aghidalgo04/SistemaDeteccionGasesHogar/SistemaDeteccionGasesHogar.srcs/sources_1/new/top_module.vhd

library IEEE;
use IEEE.STD_LOGIC_1164.ALL;

entity top_module is
    Port ( 
        CLK         : in STD_LOGIC;
        sw          : in STD_LOGIC;
        JA          : in STD_LOGIC_VECTOR(1 DOWNTO 0);
        S_CLOCK1HZ  : out STD_LOGIC;
        VENT        : out STD_LOGIC;
        LED_ZUM     : out STD_LOGIC;
        ESP_S       : out STD_LOGIC_VECTOR(1 downto 0);
        led         : out STD_LOGIC_VECTOR(15 DOWNTO 0);
        an          : out STD_LOGIC_VECTOR(3 DOWNTO 0);
        seg         : out STD_LOGIC_VECTOR(6 DOWNTO 0);
        dp          : out STD_LOGIC
    );
end top_module;

architecture Behavioral of top_module is
    component DivisorFrecuencia
        GENERIC(N: integer := 22);
        Port ( 
            CLK_10MHz : in STD_LOGIC;
            CLK_1Hz : out STD_LOGIC
        );
    end component;
    
    component display is
        Port ( 
            clk    : in  STD_LOGIC;
            bin_in : in  STD_LOGIC_VECTOR(11 DOWNTO 0);
            an     : out STD_LOGIC_VECTOR(3 DOWNTO 0);
            seg    : out STD_LOGIC_VECTOR(6 DOWNTO 0);
            dp     : out STD_LOGIC
        );
    end component;
    
    component DEMUX_1a2
        Port (
           entrada : in STD_LOGIC_VECTOR (11 downto 0);
           salida_M : out STD_LOGIC_VECTOR (11 downto 0);
           salida_C : out STD_LOGIC_VECTOR (11 downto 0);
           S : in STD_LOGIC
        );
    end component;
    
    component Registro12Bits
        GENERIC(N: integer := 12);
        Port ( 
            CLK : in STD_LOGIC;
            entrada : in STD_LOGIC_VECTOR (N-1 downto 0);
            salida : out STD_LOGIC_VECTOR (N-1 downto 0)
        );
    end component;
    
    component xadc
        Port ( 
           clk : in STD_LOGIC;
           sw : in STD_LOGIC;
           JA : in STD_LOGIC_VECTOR(1 DOWNTO 0);
           led : out STD_LOGIC_VECTOR(15 DOWNTO 0)
         );
    end component;
     
    component Comparador
        port ( 
           CO2 : in STD_LOGIC_VECTOR(11 downto 0);
           Metano : in STD_LOGIC_VECTOR(11 downto 0);
           s_vent : out STD_LOGIC;
           s_led_zum : out STD_LOGIC;
           ESP : out STD_LOGIC_VECTOR(1 downto 0)
         );
    end component;
    
    signal sCLK_1Hz, sCLK_1Hz_inv : STD_LOGIC;
    signal led_aux : STD_LOGIC_VECTOR(15 DOWNTO 0);
    signal xadc_value, salida_metano, salida_co2, salida_reg_met, salida_reg_co2: STD_LOGIC_VECTOR(11 DOWNTO 0);
    signal sS_vent, sS_led_zum : STD_LOGIC;
    signal sESP : STD_LOGIC_VECTOR(1 downto 0);
begin
    inst_divisorFrecuencia: DivisorFrecuencia
    PORT MAP(
        CLK_10MHz => CLK,
        CLK_1Hz => sCLK_1Hz
    );
    
    inst_xadc: xadc
    PORT MAP(
        clk => sCLK_1Hz,
        sw => sw,
        JA => JA,
        led => led_aux
    );
    
    xadc_value <= led_aux(15 DOWNTO 4);
    led <= led_aux;
    
    inst_demux: DEMUX_1a2
    PORT MAP(
        entrada => xadc_value,
        salida_M => salida_metano,
        salida_C => salida_co2,
        S => sCLK_1Hz
    );
    
    sCLK_1Hz_inv <= not(sCLK_1Hz);
    
    inst_registroM : Registro12Bits
    PORT MAP(
        CLK => sCLK_1Hz_inv,
        entrada => salida_metano,
        salida => salida_reg_met
    );
    
    inst_registroC : Registro12Bits
    PORT MAP(
        CLK => sCLK_1Hz,
        entrada => salida_co2,
        salida => salida_reg_co2
    );

--   ==== alternativa metano ====

--    inst_display_met : display
--    PORT MAP(
--            clk    => CLK,
--            bin_in => salida_reg_met,
--            an     => an,
--            seg    => seg,
--            dp     => dp
--    );
    
    inst_display_co2 : display
    PORT MAP(
            clk    => CLK,
            bin_in => salida_reg_co2,
            an     => an,
            seg    => seg,
            dp     => dp
    );
    
    inst_comparador : Comparador
    PORT MAP ( 
           CO2 => salida_reg_co2,
           Metano => salida_reg_met,
           s_vent => sS_vent,
           s_led_zum => sS_led_zum,
           ESP => sESP
         );

end Behavioral;
