aghidalgo04/SistemaDeteccionGasesHogar/SistemaDeteccionGasesHogar.srcs/constrs_1/new/Basys3_Master.xdc

## Clock signal
set_property PACKAGE_PIN W5 [get_ports CLK]
set_property IOSTANDARD LVCMOS33 [get_ports CLK]
create_clock -period 10.000 -name sys_clk_pin -waveform {0.000 5.000} -add [get_ports CLK]

## Switches
set_property PACKAGE_PIN V17 [get_ports sw]
set_property IOSTANDARD LVCMOS33 [get_ports sw]


## LEDs
set_property PACKAGE_PIN U16 [get_ports {led[0]}]
set_property IOSTANDARD LVCMOS33 [get_ports {led[0]}]
set_property PACKAGE_PIN E19 [get_ports {led[1]}]
set_property IOSTANDARD LVCMOS33 [get_ports {led[1]}]
set_property PACKAGE_PIN U19 [get_ports {led[2]}]
set_property IOSTANDARD LVCMOS33 [get_ports {led[2]}]
set_property PACKAGE_PIN V19 [get_ports {led[3]}]
set_property IOSTANDARD LVCMOS33 [get_ports {led[3]}]
set_property PACKAGE_PIN W18 [get_ports {led[4]}]
set_property IOSTANDARD LVCMOS33 [get_ports {led[4]}]
set_property PACKAGE_PIN U15 [get_ports {led[5]}]
set_property IOSTANDARD LVCMOS33 [get_ports {led[5]}]
set_property PACKAGE_PIN U14 [get_ports {led[6]}]
set_property IOSTANDARD LVCMOS33 [get_ports {led[6]}]
set_property PACKAGE_PIN V14 [get_ports {led[7]}]
set_property IOSTANDARD LVCMOS33 [get_ports {led[7]}]
set_property PACKAGE_PIN V13 [get_ports {led[8]}]
set_property IOSTANDARD LVCMOS33 [get_ports {led[8]}]
set_property PACKAGE_PIN V3 [get_ports {led[9]}]
set_property IOSTANDARD LVCMOS33 [get_ports {led[9]}]
set_property PACKAGE_PIN W3 [get_ports {led[10]}]
set_property IOSTANDARD LVCMOS33 [get_ports {led[10]}]
set_property PACKAGE_PIN U3 [get_ports {led[11]}]
set_property IOSTANDARD LVCMOS33 [get_ports {led[11]}]
set_property PACKAGE_PIN P3 [get_ports {led[12]}]
set_property IOSTANDARD LVCMOS33 [get_ports {led[12]}]
set_property PACKAGE_PIN N3 [get_ports {led[13]}]
set_property IOSTANDARD LVCMOS33 [get_ports {led[13]}]
set_property PACKAGE_PIN P1 [get_ports {led[14]}]
set_property IOSTANDARD LVCMOS33 [get_ports {led[14]}]
set_property PACKAGE_PIN L1 [get_ports {led[15]}]
set_property IOSTANDARD LVCMOS33 [get_ports {led[15]}]


##7 segment display
set_property PACKAGE_PIN W7 [get_ports {seg[0]}]
set_property IOSTANDARD LVCMOS33 [get_ports {seg[0]}]
set_property PACKAGE_PIN W6 [get_ports {seg[1]}]
set_property IOSTANDARD LVCMOS33 [get_ports {seg[1]}]
set_property PACKAGE_PIN U8 [get_ports {seg[2]}]
set_property IOSTANDARD LVCMOS33 [get_ports {seg[2]}]
set_property PACKAGE_PIN V8 [get_ports {seg[3]}]
set_property IOSTANDARD LVCMOS33 [get_ports {seg[3]}]
set_property PACKAGE_PIN U5 [get_ports {seg[4]}]
set_property IOSTANDARD LVCMOS33 [get_ports {seg[4]}]
set_property PACKAGE_PIN V5 [get_ports {seg[5]}]
set_property IOSTANDARD LVCMOS33 [get_ports {seg[5]}]
set_property PACKAGE_PIN U7 [get_ports {seg[6]}]
set_property IOSTANDARD LVCMOS33 [get_ports {seg[6]}]

set_property PACKAGE_PIN V7 [get_ports dp]
set_property IOSTANDARD LVCMOS33 [get_ports dp]

set_property PACKAGE_PIN U2 [get_ports {an[0]}]
set_property IOSTANDARD LVCMOS33 [get_ports {an[0]}]
set_property PACKAGE_PIN U4 [get_ports {an[1]}]
set_property IOSTANDARD LVCMOS33 [get_ports {an[1]}]
set_property PACKAGE_PIN V4 [get_ports {an[2]}]
set_property IOSTANDARD LVCMOS33 [get_ports {an[2]}]
set_property PACKAGE_PIN W4 [get_ports {an[3]}]
set_property IOSTANDARD LVCMOS33 [get_ports {an[3]}]


set_property IOSTANDARD LVCMOS33 [get_ports {JA[1]}]
set_property IOSTANDARD LVCMOS33 [get_ports {JA[0]}]
set_property PACKAGE_PIN H1 [get_ports {JA[0]}]
set_property IOSTANDARD LVCMOS33 [get_ports {ESP_S[1]}]
set_property IOSTANDARD LVCMOS33 [get_ports {ESP_S[0]}]
set_property PACKAGE_PIN K17 [get_ports {ESP_S[0]}]
set_property PACKAGE_PIN M18 [get_ports {ESP_S[1]}]
set_property IOSTANDARD LVCMOS33 [get_ports LED_ZUM]
set_property PACKAGE_PIN N17 [get_ports LED_ZUM]
set_property IOSTANDARD LVCMOS33 [get_ports S_CLOCK1HZ]
set_property PACKAGE_PIN P18 [get_ports S_CLOCK1HZ]
set_property IOSTANDARD LVCMOS33 [get_ports VENT]
set_property PACKAGE_PIN L17 [get_ports VENT]
