aghidalgo04/SistemaDeteccionGasesHogar/SistemaDeteccionGasesHogar.srcs/sources_1/new/Biestable_D.vhd

library IEEE;
use IEEE.STD_LOGIC_1164.ALL;

entity Biestable_D is
    Port ( CLK : in STD_LOGIC;
           D : in STD_LOGIC;
           Q : out STD_LOGIC);
end Biestable_D;

architecture Behavioral of Biestable_D is
    signal qAux: STD_LOGIC := '0';
begin
    process(CLK)
    begin
        if rising_edge(CLK) then -- Forma estándar de detectar el flanco de subida
            Q <= D;
        end if;
    end process;
end Behavioral;
