aghidalgo04/SistemaDeteccionGasesHogar/(commit log)

2026-01-03 Top Module and xdc fix
    [Basys3_Master.xdc, top_module.vhd]
2026-01-03 Top Module and xdc fix v2
    [Basys3_Master.xdc, top_module.vhd]
